t3hbeowulf/itxllama/docs/storage.md

# ITX Llama Storage Options

The ITX Llama provides several convenient options for installing your favorite version of DOS, Windows 3.1, and/or Windows 95/98. 

With an onboard SATA port, you can use a SATA SSD or even an HDD for a more authentic speed and sound. There is a microSD card slot which BIOS intializes as a mass storage device, usable by DOS and Windows without special drivers. Two of the USB ports on the rear can be configured in "Removable mode" or "Mass Storage" mode as well. 

## Configuration Examples

1. Easy mode:
    * Operating system is stored on the internal microSD card
    * Optical drive or optical drive emulator is connected to the SATA port
    * USB drive is attached in Mass Storage mode for bulk storage

1. Hard mode:
    * Operating system is stored on a SATA SSD
    * Internal microSD card is bulk storage and hosts ISOs to be mounted by the OS
    * USB drive is attached in Removable mode, usable only in Windows 95/98 with drivers
