t3hbeowulf/itxllama/kicad/ITX-Llama.kicad_sch

## KiCad design kicad/ITX-Llama.kicad_sch (2025-06-28)

Schematic: ITX-Llama.kicad_sch

Parts:
BT1: CR2032; BT_BS-02-A1AJ006; LCSC C964745
C1, C2, C3, C4: 100uF; C_1210_3225Metric; LCSC C90143
C5, C10, C11, C31, C32, C43, C44, C45, C46, C47, C53, C61, C62, C76, C77, C159, C161, C167, C168, C169, C170, C171, C173: 47uF; C_0603_1608Metric; LCSC C140782
C6, C7, C8, C12, C13, C14, C16, C17, C18, C22, C25, C26, C29, C37, C38, C39, C40, C41, C42, C51, C54, C56, C57, C58, C59, C60, C63, C72, C73, C84, C85, C86, C87, C89, C90, C91, C92, C93, C94, C95, C96, C97, C98, C99, C100, C101, C102, C103, C104, C105, C106, C107, C108, C109, C110, C111, C112, C113, C114, C115, C116, C117, C118, C119, C120, C122, C123, C124, C129, C130, C131, C138, C144, C145, C146, C153, C156, C162, C163, C164, C165, C166, C182, C183, C184, C185, C186, C187, C188, C189, C190: 0.1uF; C_0402_1005Metric
C9, C33, C34, C52, C69, C74, C75, C134, C137, C143, C147, C148, C149, C158, C176: 10uF; C_0603_1608Metric
C15, C24, C28, C65, C66, C67, C78, C121, C132, C135, C150, C151, C152, C177, C178: 1uF; C_0402_1005Metric
C19, C23, C35, C36, C125, C126: 1nF; C_0402_1005Metric
C20, C21: 22pF; C_0402_1005Metric
C27: 47uF; C_0603_1608Metric
C30, C68: 2.7nF; C_0603_1608Metric
C48, C49, C50: 330pF; C_0402_1005Metric
C55, C64, C160: 10nF; C_0402_1005Metric
C70, C71: 0.33uF; C_0402_1005Metric
C79, C133, C136, C157: 470pF; C_0402_1005Metric
C80: 1nF; C_1812_4532Metric; Voltage min. 2kV; LCSC C106132
C81, C82, C83: 0.1uF; C_0402_1005Metric; LCSC C14663
C88, C154, C155: 4.7uF; C_0603_1608Metric
C127, C128: 5.6nF; C_0402_1005Metric
C139, C140: 2.2uF; C_0603_1608Metric
C141, C142: 2.2nF; C_0402_1005Metric
C172, C174, C175: 10uF; C_0603_1608Metric; LCSC C140782
C179: 0.1uF; C_0402_1005Metric; LCSC C107004
C180, C181: 30pF; C_0402_1005Metric; LCSC C107004
D1: RGB_LED; D_LED_D5.0mm-4_RGB; LCSC C417349
D2, D3, D4: 1N4148; D_SOD-323F; LCSC C2128
F1, F2, F5, F6, F7: F; Fuse_0603_1608Metric
F3, F4: F; Fuse_0603_1608Metric; LCSC C207017
FB1, FB2: 600Ω@100MHz; R_0402_1005Metric; LCSC C160977
FB3: 50Ω@100MHz; R_1206_3216Metric; LCSC C88997
FB4, FB5, FB6, FB7, FB8, FB9: 70Ω@100MHz; R_0603_1608Metric; LCSC C113031
H1, H2, H3, H4: H_HOLE; H_ATX_PERF
J1: ATX_POWER; J_ATX_5.5mm; LCSC C114125
J2: MICRO_SD; J_MicroSD_TF01A; LCSC C91145
J3: FRONT_PANEL; P_CONN_PANEL; LCSC C492421
J4: PS/2; J_PS2_KMDGX
J5: AGP_3.3V; J_TE_5145263-3
J6: CLICK_VOL; P_CONN_SPKR_VOL
J7: MSC; P_CONN_01X03
J8: COM1; J_DE9M; LCSC C141880
J9: INT_SPKR_VOL; P_CONN_SPKR_VOL
J10: SATA; J_SATA; LCSC C2926809
J11: SPEAKER; P_CONN_01X04; LCSC C492403
J12: MSD; P_CONN_01X03
J14: AUDIO; J_AUDIO_ABA-JAK-027-K24; LCSC C962118
J15: KBC; P_CONN_01X03
J16: KBD; P_CONN_01X03
J17: USB_ETH; J_USB_A_ETH_C3000093; LCSC C3000093
J18: USB_HID; J_USB_A_C456021; LCSC C456021
J19: HID_POWER; P_CONN_01X02
J20: FAN1; J_MOLEX_47053-1000; LCSC C240840
J21: FAN2; J_MOLEX_47053-1000; LCSC C240840
J22: GAMEPORT; J_DA15; LCSC C77835
J23: WAVETABLE; J_CONN_WAVETABLE; LCSC C2884022
J24: PI_ZERO2; J_CONN_RPI_SMD; LCSC C3975165
J25: POWER; P_CONN_01X03
J26: LEFT; P_CONN_01X03
J27: RIGHT; P_CONN_01X03
J28: COM2_TTL; P_CONN_01X03
J29: PI_2/3/4; J_CONN_RPI_SMD_PI3; LCSC C2884029
J30: FAN3; J_MOLEX_47053-1000; LCSC C240840
J31: FAN1_VDD; P_CONN_01X03
J32: FAN2_VDD; P_CONN_01X03
J33: FAN3_VDD; P_CONN_01X03
J34: CD_IN; J_CONN_CD_AUDIO; LCSC C41927
J35: D1_MINI; J_WEMOS_D1_MINI
J36: ESP_POWER; P_CONN_01X02
J38: J_TOSLINK_ZGY133T10; LCSC C277782
J39: LINE_L; P_CONN_01X03
J40: LINE_R; P_CONN_01X03
J41: EXT_SYNTH; J_CONN_02X10
J42: PI_I2C; P_CONN_01X04
J43: I2C; P_CONN_01X04_NO_3D
J46: RP_DEBUG; P_CONN_01X03
L1, L2: L_EMI_FILTER; L_EMI_FILTER_MCM2012B900GBE; LCSC C315725
L3, L4: L_EMI_FILTER; L_EMI_FILTER_MCM2012B900GBE
LOGO1: Llama_logo; LLAMA_LOGO
OUTLINE1: Outline; OUTLINE_PANELIZED
P1: P_SOM-128-EX; P_CONN_SOM-128-EX_FAN; LCSC C2881937
Q1, Q2, Q3, Q4, Q5, Q6, Q7: NPN; Q_BJT_SOT-23-3; LCSC C2146
Q8, Q9, Q10, Q11: Q_NMOS_GDS; Q_NFET_ENH_SOT-23-3; LCSC C255592
R1, R2, R3, R4, R5, R6, R27, R60, R61: 47k; R_0402_1005Metric
R7, R8, R9, R11, R12, R40, R53, R118: 33; R_0402_1005Metric
R10: 0; R_0402_1005Metric
R13, R20, R42, R57, R81, R82, R87, R88, R97, R100, R102, R110, R111, R112, R115, R120: 10k; R_0402_1005Metric
R14, R98, R101: 470; R_0402_1005Metric
R15, R16, R28, R62, R66, R67, R84, R85, R86, R89, R90, R91: 4.7k; R_0402_1005Metric
R17, R63: 600; R_0402_1005Metric
R18, R74, R75, R116: 330; R_0402_1005Metric
R19, R64: 2k; R_0402_1005Metric
R21, R22, R24, R25, R103, R104, R105, R106: 6.8k; R_0402_1005Metric
R23, R26, R29, R30, R31, R32, R33, R34, R35, R36, R37, R38, R41, R46, R47, R48, R49, R50, R51, R52, R54, R79, R80, R108, R121: 5.1k; R_0402_1005Metric
R39, R117: 200; R_0402_1005Metric
R43, R44, R55, R58, R78, R119: 1k; R_0402_1005Metric
R45, R56: 27; R_0402_1005Metric
R59, R94, R95, R96: 470; R_0805_2012Metric; LCSC C17710
R65: 1.43k; R_0402_1005Metric
R68, R69, R76, R77: 75; R_0402_1005Metric
R70, R71, R72, R73: 49.9; R_0402_1005Metric
R83, R107: 3.4k; R_0402_1005Metric
R92, R93: 2.2k; R_0402_1005Metric
R99: 20k; R_0402_1005Metric
R109: 22; R_0402_1005Metric
R113: 15.8k; R_0402_1005Metric
R114: 36k; R_0402_1005Metric
SP1, SP2: SPEAKER; SP; LCSC C252917
SW1: POWER; SW_B3FS-1010; LCSC C271750
SW2: RESET; SW_B3FS-1010; LCSC C271750
SW3: CH559_PRG; SW_B3FS-1010; LCSC C271750
T1: Pulse_H1102NL; T_PULSE_H1102NL; LCSC C18584
U1: MAX16054; U_TSOT-23-6; LCSC C79401
U2: U_74LVC1G04; U_SOT-23-5; LCSC C7827
U3: U_CS4237B-KQ; U_TQFP-100_14x14mm_P0.5mm_HandSoldering
U4: GD75232; U_TSSOP-20_4.4x6.5mm_P0.65mm; LCSC C543039
U5: U_MC33078; SOIC-8_3.9x4.9mm_P1.27mm; LCSC C108206
U6: PI7C9X118SL; U_LQFP-128_14x14mm_P0.4mm_EP
U7: AP7165; U_Diodes_SO-8EP; LCSC C460364
U8, U10, U13, U14: U_MIC5219-3.3YM5; U_SOT-23-5; LCSC C29613
U9: U_ATTINY84A; U_DIP-14_W7.62mm
U11: EMC2303; U_EMC2303; LCSC C621414
U12: PCM5102A; U_TSSOP-20_4.4x6.5mm_P0.65mm; LCSC C107671
U15: W25Q32JVSS; U_SOIC-8_5.23x5.23mm_P1.27mm
U16: U_74LVC1G126; U_SOT-23-5; LCSC C7834
U17: U_RP2040; U_QFN40P700X700X90-57N
X1: 16.9344MHz; X_Crystal_SMD_HC49S-MINI; LCSC C4944017
X2: 12MHz; X_SMD3225; LCSC C9002

Connections:
3.3V_MIDI_OUT: J24.10 (BCM15/RDX), J29.10 (BCM15/RDX), R99.1, R100.2
+1.8V: FB3.1, P1.A56 (VCC1.8_OUT)
+1.15V: C75.2, C153.2, FB6.1, FB7.1, R113.1, U7.7 (VOUT), U7.8 (VOUT)
+1.15V_VDDA: C101.2, C102.2, C155.2, FB7.2, U6.15 (VDDA), U6.18 (VDDA)
+1.15V_VDDC: C89.2, C90.2, C91.2, C92.2, C93.2, C94.2, C95.2, C96.2, C97.2, C98.2, C99.2, C100.2, C154.2, FB6.2, U6.7 (VDDCAUX), U6.30 (VDDC), U6.35 (VDDC), U6.45 (VDDC), U6.53 (VDDC), U6.62 (VDDC), U6.73 (VDDC), U6.81 (VDDC), U6.95 (VDDC), U6.105 (VDDC), U6.114 (VDDC), U6.127 (VDDC)
+3.3V: C3.1, C7.1, C12.1, C22.2, C74.2, C122.1, FB4.1, FB5.1, FB8.1, FB9.1, J1.1 (+3.3V), J1.2 (+3.3V), J1.12 (+3.3V), J1.13 (+3.3V), J2.4 (VDD), R1.1, R2.1, R3.1, R4.1, R5.1, R6.1, R74.1, R75.1, R79.1, R80.1, R84.2, R85.2, R86.2, R87.1, R88.1, R95.1, R102.1, R120.2, U2.5 (VCC), U3.45 (VD1), U7.1 (VIN), U7.2 (VIN), U7.4 (EN), U11.3 (VDD)
+3.3VSB: C156.2, C158.1, U9.1 (VCC), U10.5 (OUT)
+3.3V_118SL: C103.2, C104.2, C105.2, C106.2, C107.2, C108.2, C109.2, C110.2, C111.2, C112.2, C113.2, C114.2, C115.2, C116.2, C117.2, C118.2, C119.2, FB4.2, R33.2, R34.2, R36.1, R37.1, R38.1, R51.1, R52.1, R54.1, R108.2, R121.2, U6.2 (VAUX), U6.25 (VD33), U6.38 (VD33), U6.50 (VD33), U6.55 (VD33), U6.58 (VD33), U6.66 (VD33), U6.72 (VD33), U6.77 (VD33), U6.82 (VD33), U6.87 (VD33), U6.91 (VD33), U6.101 (VD33), U6.107 (VD33), U6.112 (VD33), U6.118 (VD33), U6.123 (VD33)
+3.3V_PCM_A: C137.1, C143.1, C144.1, U12.8 (AVDD), U14.5 (OUT)
+3.3V_PCM_D: C134.1, C138.1, C145.1, C147.1, C148.1, U12.1 (CPVDD), U12.17 (XSMT), U12.20 (DVDD), U13.5 (OUT)
+3.3V_VDDA: C88.2, C120.2, FB5.2, U6.10 (VDDA33)
+5VA: C25.1, C72.1, FB1.2, U3.81 (VA), U5.8 (VCC)
+5VFILT: C13.2, C14.2, C16.2, C18.2, FB2.2, U3.17 (VDF1), U3.54 (VDF4), U3.65 (VDF2), U3.98 (VDF3)
+5VSB: C8.2, C121.1, D1.2 (A), J1.9 (+5VSB), R59.1, U1.6 (VCC), U10.1 (IN), U10.3 (EN)
+12V: C1.1, C51.2, C52.2, C172.1, C174.1, C175.1, J1.10 (+12V), J1.11 (+12V), J5.A1 (+12V), J23.18 (+12V), J31.1, J32.1, J33.1, R96.1, U4.1 (VDD)
-12V: C4.2, J1.14 (-12V), J23.22 (-12V), U4.10 (VSS)
A0: P1.B3 (GP70), U3.25 (SA0)
A1: P1.B4 (GP71), U3.26 (SA1)
A2: P1.B5 (GP72), U3.27 (SA2)
A3: P1.B6 (GP73), U3.28 (SA3)
A4: P1.B7 (GP74), U3.29 (SA4)
A5: P1.B8 (GP75), U3.30 (SA5)
A6: P1.B9 (GP76), U3.31 (SA6)
A7: P1.B10 (GP77), U3.32 (SA7)
A8: P1.B11 (GP60), U3.33 (SA8)
A9: P1.B12 (GP61), U3.34 (SA9)
A10: P1.B13 (GP62), U3.35 (SA10)
A11: P1.B14 (GP63), U3.36 (SA11)
A12: P1.B15 (GP64), U3.94 (SA12)
A13: P1.B16 (GP65), U3.93 (SA13)
A14: P1.B17 (GP66), U3.92 (SA14)
A15: P1.B18 (GP67), U3.91 (SA15)
AD_STB0: J5.B59 (AD_STB0), R26.2
AD_STB1: J5.B32 (AD_STB1), R29.2
AEN: P1.B33 (GP44), U3.39 (AEN)
AUDIO_L_PI: C141.2, J26.3, R98.2
AUDIO_L_WT: J23.24 (AUDIO_L), J26.1
AUDIO_R_PI: C142.2, J27.3, R101.2
AUDIO_R_WT: J23.20 (AUDIO_R), J27.1
AUDIO_VREF: R60.2, U3.78 (VREF)
BOOTSEL: R43.2, SW3.1 (A)
CTS1: P1.A10 (GP07), U4.14 (RY4)
D0: P1.B47 (GP20), U3.41 (SD0)
D1: P1.B48 (GP21), U3.42 (SD1)
D2: P1.B49 (GP22), U3.43 (SD2)
D3: P1.B50 (GP23), U3.44 (SD3)
D4: P1.B51 (GP24), U3.47 (SD4)
D5: P1.B52 (GP25), U3.48 (SD5)
D6: P1.B53 (GP26), U3.49 (SD6)
D7: P1.B54 (GP27), U3.50 (SD7)
DCD1: P1.A3 (GP00), U4.19 (RY1)
DRQ1: P1.B27 (GP56), U3.51 (DRQB(DRQ1*))
DSR1: P1.A9 (GP06), U4.18 (RY2)
DTR1: P1.A8 (GP05), U4.13 (DA3)
FM_A0: J41.18, U3.14 (SCL/XA0)
FM_A1: J41.16, U3.13 (XA1)
FM_D0: J41.12, U3.8 (SDA/XD0)
FM_D1: J41.11, U3.7 (XD1/SCLK)
FM_D2: J41.10, U3.6 (XD2/SDIN)
FM_D3: J41.9, U3.5 (XD3/SDOUT)
FM_D4: J41.8, U3.4 (XD4/FSYNC)
FM_D5: J41.7, U3.3 (XD5/MCLK)
FM_D6: J41.6, U3.2 (XD6/LRCK)
FM_D7: J41.5, U3.1 (XD7/SDATA)
FM_SYNTH_L: C24.2, J41.1
FM_SYNTH_R: C28.2, J41.2
GND: BT1.2 (-), C1.2, C2.2, C3.2, C4.1, C5.2, C6.2, C7.2, C8.1, C9.2, C10.1, C11.1, C12.2, C13.1, C14.1, C15.2, C16.1, C17.2, C18.1, C19.2, C20.1, C21.1, C22.1, C23.2, C25.2, C26.1, C27.1, C30.2, C31.2, C32.2, C35.2, C36.2, C37.1, C38.1, C39.1, C40.1, C41.1, C42.1, C43.2, C44.2, C45.2, C46.2, C47.2, C48.1, C49.1, C50.1, C51.1, C52.1, C53.2, C54.1, C55.2, C56.1, C57.1, C58.1, C59.1, C60.1, C61.2, C62.2, C63.1, C64.2, C67.1, C69.2, C72.2, C74.1, C75.1, C76.2, C77.2, C78.2, C79.2, C80.1, C81.1, C82.1, C83.1, C88.1, C89.1, C90.1, C91.1, C92.1, C93.1, C94.1, C95.1, C96.1, C97.1, C98.1, C99.1, C100.1, C101.1, C102.1, C103.1, C104.1, C105.1, C106.1, C107.1, C108.1, C109.1, C110.1, C111.1, C112.1, C113.1, C114.1, C115.1, C116.1, C117.1, C118.1, C119.1, C120.1, C121.2, C122.2, C123.1, C124.1, C125.1, C126.1, C127.1, C128.1, C129.1, C130.1, C131.1, C132.2, C133.2, C134.2, C135.2, C136.2, C137.2, C138.2, C139.1, C141.1, C142.1, C143.2, C144.2, C145.2, C146.1, C147.2, C148.2, C149.1, C153.1, C154.1, C155.1, C156.1, C157.2, C158.2, C159.2, C160.2, C161.2, C162.1, C163.2, C164.1, C165.1, C166.1, C167.2, C168.2, C169.2, C170.2, C171.2, C172.2, C173.2, C174.2, C175.2, C176.2, C177.2, C178.2, C179.1, C180.2, C181.2, C182.1, C183.1, C184.1, C185.1, C186.1, C187.1, C188.1, C189.1, C190.1, H1.1, H2.1, H3.1, H4.1, J1.3 (GND), J1.5 (GND), J1.7 (GND), J1.15 (GND), J1.17 (GND), J1.18 (GND), J1.19 (GND), J1.24 (GND), J2.6 (VSS), J2.S (Shield), J3.4, J3.5, J4.A3 (GND), J4.B3 (GND), J4.S (SHIELD), J5.A3 (RES_GND), J5.A5 (GND), J5.A13 (GND), J5.A19 (GND), J5.A31 (GND), J5.A37 (GND), J5.A43 (GND), J5.A49 (GND), J5.A55 (GND), J5.A61 (GND), J5.B5 (GND), J5.B13 (GND), J5.B19 (GND), J5.B31 (GND), J5.B37 (GND), J5.B43 (GND), J5.B49 (GND), J5.B55 (GND), J5.B61 (GND), J8.5, J10.1 (GND), J10.4 (GND), J10.7 (GND), J11.3, J14.1, J17.U4 (GND1), J17.U8 (GND2), J18.4 (GND1), J18.8 (GND2), J18.S (Shield), J20.1 (GND), J21.1 (GND), J22.4, J22.5, J22.S (SHIELD), J23.1 (GND), J23.3 (GND), J23.5 (GND), J23.7 (GND), J23.9 (GND), J23.11 (GND), J23.15 (AGND), J23.17 (AGND), J23.19 (AGND), J23.21 (AGND), J23.23 (AGND), J23.25 (AGND), J24.6 (GND), J24.9 (GND), J24.14 (GND), J24.20 (GND), J24.25 (GND), J24.30 (GND), J24.34 (GND), J24.39 (GND), J28.2, J29.6 (GND), J29.9 (GND), J29.14 (GND), J29.20 (GND), J29.25 (GND), J29.30 (GND), J29.34 (GND), J29.39 (GND), J30.1 (GND), J35.10 (GND), J38.3 (GND), J41.3, J41.20, J42.1 (GND), J43.1 (GND), J46.2, P1.A2 (GND), P1.A19 (GND), P1.A20 (GND), P1.A25 (AGND), P1.A26 (AGND), P1.A35 (GND), P1.A36 (GND), P1.A49 (GND), P1.A50 (GND), P1.A64 (GP87), P1.B19 (GND), P1.B20 (GND), P1.B37 (GND), P1.B38 (GND), P1.B55 (GND), P1.B56 (GND), Q1.2 (E), Q2.2 (E), Q3.2 (E), Q4.2 (E), Q5.2 (E), Q6.2 (E), Q7.2 (E), R22.2, R25.2, R28.2, R59.2, R78.2, R94.2, R95.2, R96.2, R99.2, R105.2, R106.2, R107.2, R114.2, SW1.1 (A), SW2.1 (A), SW3.2 (B), U1.2 (GND), U1.3 (CLEAR), U3.18 (SGND1), U3.46 (DGND1), U3.53 (SGND4), U3.66 (SGND2), U3.71 (TEST), U3.80 (AGND), U3.97 (SGND3), U4.11 (GND), U5.4 (GND), U6.6 (VSS), U6.11 (VSS), U6.14 (VSS), U6.19 (VSS), U6.22 (VSS), U6.23 (TM1), U6.42 (VSS), U6.44 (CLKIN), U6.65 (VSS), U6.84 (VSS), U6.115 (VSS), U6.128 (TM0), U6.129 (EPAD), U7.5 (GND), U7.9 (GND), U8.2 (GND), U9.14 (GND), U10.2 (GND), U11.9 (CLK), U11.13 (GND), U12.3 (CPGND), U12.9 (AGND), U12.10 (DEMP), U12.11 (FLT), U12.12 (SCK), U12.16 (FMT), U12.19 (DGND), U13.2 (GND), U14.2 (GND), U15.4 (GND), U16.3 (GND), U17.19 (TESTEN), U17.57 (GND), X2.2, X2.4
HDD_LED+: J3.1, R116.2
HDD_LED-: J3.2, Q6.3 (C)
HID_VCC: C78.1, F5.1, F6.1, J19.2, U8.1 (IN), U8.3 (EN)
I2S_BCLK: J24.12 (BCM18/PWM0), J29.12 (BCM18/PWM0), U12.13 (BCK)
I2S_DATA: J24.40 (BCM21/SCLK), J29.40 (BCM21/SCLK), U12.14 (DIN)
I2S_LRCLK: J24.35 (BCM19/MISO), J29.35 (BCM19/MISO), U12.15 (LRCK)
INT_MIDI_L: J26.2, J39.1
INT_MIDI_R: J27.2, J40.1
IOCHRDY: P1.B34 (GP45), U3.40 (IOCHRDY)
IRQ7: P1.B21 (GP50), U3.23 ((INT7*)IRQB)
JAB1: C126.2, J22.2, R91.2, U3.70 (JAB1)
JAB2: C125.2, J22.7, R90.2, U3.61 (JAB2)
JACX: C128.2, R92.2, U3.68 (JACX)
JACX_: J22.3, R92.1
JACY: C127.2, R93.2, U3.63 (JACY)
JACY_: J22.6, R93.1
KBCLK: J15.2, P1.A12 (GP91), R66.1
KBDATA: J16.2, P1.A14 (GP93), R67.1
LAN_RD+: P1.A54 (LAN_RX+), R72.2, T1.6 (RD+)
LAN_RD-: P1.A52 (LAN_RX-), R73.2, T1.8 (RD-)
LAN_TD+: P1.A53 (LAN_TX+), R70.2, T1.1 (TD+)
LAN_TD-: P1.A51 (LAN_TX-), R71.2, T1.3 (TD-)
LIN: J14.10, J39.3
LINE_IN_L: J39.2, R21.1
LINE_IN_R: J40.2, R24.1
LMIC: C73.1, J14.3
LOUT: C34.2, J14.7
M66EN: R121.1, U6.102 (M66EN)
MIDI_IN: J22.15, R89.2, U3.59 (MIDIN)
MIDI_OUT: J22.12, J23.4 (MIDI_IN), R100.1, U3.60 (MIDOUT)
MSCLK: J7.2, P1.A13 (GP92), R15.1
MSDATA: J12.2, P1.A15 (GP94), R16.1
unnamed: C10.2, F1.2, J4.A4 (VCC)
unnamed: C11.2, F2.2, J4.B4 (VCC)
unnamed: C15.1, C17.1, U3.79 (REFFLT)
unnamed: C19.1, U3.76 (RFILT)
unnamed: C20.2, U3.99 (XTALO), X1.1
unnamed: C21.2, U3.100 (XTALI), X1.2
unnamed: C23.1, U3.77 (LFILT)
unnamed: C24.1, U3.87 (LLINE)
unnamed: C28.1, U3.86 (RLINE)
unnamed: C29.1, U3.88 (MIN)
unnamed: C29.2, C30.1, R27.2, R28.1
unnamed: C31.1, F3.2, J17.U1 (VBUS1)
unnamed: C32.1, F4.2, J17.U5 (VBUS2)
unnamed: C33.1, C36.1, U3.72 (ROUT)
unnamed: C34.1, C35.1, U3.73 (LOUT)
unnamed: C55.1, Q1.3 (C), R39.1, R40.1
unnamed: C64.1, Q2.3 (C), R53.2
unnamed: C65.1, U3.74 (RAUX1)
unnamed: C65.2, R24.2, R25.1
unnamed: C66.1, U3.75 (LAUX1)
unnamed: C66.2, R21.2, R22.1
unnamed: C67.2, R60.1, U5.3 (+)
unnamed: C68.1, C70.1, C71.1, R62.1, U5.7
unnamed: C68.2, R62.2, R63.1, U5.6 (-)
unnamed: C69.1, R63.2
unnamed: C70.2, U3.83 (LMIC)
unnamed: C71.2, U3.82 (RMIC)
unnamed: C73.2, R61.2, U5.5 (+)
unnamed: C76.1, F5.2, J18.1 (VBUS1)
unnamed: C77.1, F6.2, J18.5 (VBUS2)
unnamed: C79.1, U8.4 (BYP)
unnamed: C80.2, R68.1, R69.1, R76.1, R77.1
unnamed: C81.2, FB3.2, T1.2 (C_TD), T1.7 (C_RD)
unnamed: C82.2, R70.1, R71.1
unnamed: C83.2, R72.1, R73.1
unnamed: C123.2, F7.1, J22.1, J22.8, J22.9
unnamed: C133.1, U13.4 (BYP)
unnamed: C136.1, U14.4 (BYP)
unnamed: C139.2, U12.5 (VNEG)
unnamed: C140.1, U12.2 (CAPP)
unnamed: C140.2, U12.4 (CAPM)
unnamed: C146.2, C149.2, U12.18 (LDOO)
unnamed: C150.1, U3.85 (LAUX2)
unnamed: C150.2, R104.1, R105.1
unnamed: C151.1, U3.84 (RAUX2)
unnamed: C151.2, R103.1, R106.1
unnamed: C152.1, U3.96 (CMAUX2)
unnamed: C152.2, R83.1, R107.1
unnamed: C157.1, U10.4 (BYP)
unnamed: C160.1, Q3.3 (C), R117.1, R118.1
unnamed: C161.1, J35.9 (5V), J36.2
unnamed: C180.1, R58.2, X2.3
unnamed: C181.1, U17.20 (XIN), X2.1
unnamed: D1.1 (RK), R17.2
unnamed: D1.3 (GK), R19.2
unnamed: D2.2 (A), J9.2, SP1.2
unnamed: D3.2 (A), J11.1, R53.1
unnamed: D4.2 (A), J6.2, SP2.2
unnamed: J6.1, R117.2
unnamed: J6.3, R118.2
unnamed: J9.1, R39.2
unnamed: J9.3, R40.2
unnamed: J17.D1, R74.2
unnamed: J17.D3, R75.2
unnamed: J17.J1, T1.16 (TX+)
unnamed: J17.J2, T1.14 (TX-)
unnamed: J17.J3, T1.11 (RX+)
unnamed: J17.J4, J17.J5, R76.2
unnamed: J17.J6, T1.9 (RX-)
unnamed: J17.J7, J17.J8, R77.2
unnamed: J20.2 (VDD), J31.2
unnamed: J21.2 (VDD), J32.2
unnamed: J30.2 (VDD), J33.2
unnamed: J34.1, R103.2
unnamed: J34.2, J34.3, R83.2
unnamed: J34.4, R104.2
unnamed: J38.1 (VIN), U16.4
unnamed: Q1.1 (B), R44.2
unnamed: Q2.1 (B), R55.2
unnamed: Q3.1 (B), R119.2
unnamed: Q4.1 (B), R81.2
unnamed: Q4.3 (C), R17.1
unnamed: Q5.1 (B), R82.2
unnamed: Q5.3 (C), R19.1
unnamed: Q6.1 (B), R115.2
unnamed: Q7.1 (B), R20.2
unnamed: R36.2, U6.32 (~REQ1)
unnamed: R37.2, U6.34 (~REQ2)
unnamed: R38.2, U6.33 (~REQ3)
unnamed: R45.2, U17.47 (USB_DP)
unnamed: R56.2, U17.46 (USB_DM)
unnamed: R57.2, U17.26 (RUN)
unnamed: R58.1, U17.21 (XOUT)
unnamed: R61.1, R64.1, U5.1, U5.2 (-)
unnamed: R65.1, U6.8 (REXTP)
unnamed: R65.2, U6.9 (REXTN)
unnamed: R68.2, T1.10 (C_RX)
unnamed: R69.2, T1.15 (C_TX)
unnamed: R78.1, U6.24 (TMS)
unnamed: R86.1, U11.4 (ADDR_SEL)
unnamed: R98.1, U12.6 (OUTL)
unnamed: R101.1, U12.7 (OUTR)
unnamed: R108.1, U6.1 (~PME)
unnamed: R109.2, U6.59 (CLKOUT0)
unnamed: R113.2, R114.1, U7.6 (FB)
unnamed: R120.1, U9.4 (PB3/PCINT11/~RESET)
PAR: J5.A50 (PAR), U6.94 (PAR)
PCI_AD0: J5.A65 (AD[0]), U6.64 (AD0)
PCI_AD1: J5.B65 (AD[1]), U6.67 (AD1)
PCI_AD2: J5.A63 (AD[2]), U6.69 (AD2)
PCI_AD3: J5.B63 (AD[3]), U6.68 (AD3)
PCI_AD4: J5.A62 (AD[4]), U6.70 (AD4)
PCI_AD5: J5.B62 (AD[5]), U6.71 (AD5)
PCI_AD6: J5.A60 (AD[6]), U6.74 (AD6)
PCI_AD7: J5.B60 (AD[7]), U6.75 (AD7)
PCI_AD8: J5.B57 (AD[8]), U6.78 (AD8)
PCI_AD9: J5.A56 (AD[9]), U6.79 (AD9)
PCI_AD10: J5.B56 (AD[10]), U6.80 (AD10)
PCI_AD11: J5.A54 (AD[11]), U6.83 (AD11)
PCI_AD12: J5.B54 (AD[12]), U6.85 (AD12)
PCI_AD13: J5.A53 (AD[13]), U6.86 (AD13)
PCI_AD14: J5.B53 (AD[14]), U6.88 (AD14)
PCI_AD15: J5.A51 (AD[15]), U6.90 (AD15)
PCI_AD16: J5.A39 (AD[16]), U6.104 (AD16)
PCI_AD17: J5.B38 (AD[17]), U6.103 (AD17)
PCI_AD18: J5.A38 (AD[18]), U6.106 (AD18)
PCI_AD19: J5.B36 (AD[19]), U6.108 (AD19)
PCI_AD20: J5.A36 (AD[20]), U6.109 (AD20)
PCI_AD21: J5.B35 (AD[21]), U6.110 (AD21)
PCI_AD22: J5.A35 (AD[22]), U6.111 (AD22)
PCI_AD23: J5.B33 (AD[23]), U6.113 (AD23)
PCI_AD24: J5.A30 (AD[24]), U6.117 (AD24)
PCI_AD25: J5.B30 (AD[25]), U6.119 (AD25)
PCI_AD26: J5.A29 (AD[26]), U6.120 (AD26)
PCI_AD27: J5.B29 (AD[27]), U6.122 (AD27)
PCI_AD28: J5.A27 (AD[28]), U6.121 (AD28)
PCI_AD29: J5.B27 (AD[29]), U6.124 (AD29)
PCI_AD30: J5.A26 (AD[30]), U6.126 (AD30)
PCI_AD31: J5.B26 (AD[31]), U6.125 (AD31)
PCI_CLK0: J5.B7 (CLK), R109.1
PE0_CLK+: C85.2, P1.A45 (PE0_CLK-)
PE0_CLK+_: C85.1, U6.13 (REFCLKP)
PE0_CLK-: C84.2, P1.A47 (PE0_CLK+)
PE0_CLK-_: C84.1, U6.12 (REFCLKN)
PE0_RX+: C87.2, P1.A44 (PE0_RX+)
PE0_RX+_: C87.1, U6.17 (TP)
PE0_RX-: C86.2, P1.A42 (PE0_RX-)
PE0_RX-_: C86.1, U6.16 (TN)
PE0_TX+: P1.A41 (PE0_TX-), U6.21 (RP)
PE0_TX-: P1.A43 (PE0_TX+), U6.20 (RN)
PI7_SCL: R80.2, U6.3 (SCL)
PI7_SDA: R79.2, U6.5 (SDA)
PI_SCL: J24.5 (BCM3/SCL), J29.5 (BCM3/SCL), J42.3 (SCL)
PI_SDA: J24.3 (BCM2/SDA), J29.3 (BCM2/SDA), J42.4 (SDA)
PS2_KBCLK: J4.A5 (KBCLK), J15.3
PS2_KBDATA: J4.A1 (KBDATA), J16.3
PS2_MSCLK: J4.B5 (MSCLK), J7.3
PS2_MSDATA: J4.B1 (MSDATA), J12.3
PWM1: J20.4 (PWM), U11.5 (PWM1)
PWM2: J21.4 (PWM), U11.7 (PWM2)
PWM3: J30.4 (PWM), U11.11 (PWM3)
PWM_CLICK: R119.1, U9.8 (PCINT5/OC1B/PA5)
PWM_GREEN: R82.1, U9.10 (PCINT3/PA3)
PWM_HDD: R115.1, U9.12 (PCINT1/PA1)
PWM_PWR: R20.1, U9.13 (PCINT0/PA0)
PWM_RED: R81.1, U9.11 (PCINT2/PA2)
PWR_LED+: J3.8, R18.2
PWR_LED-: J3.7, Q7.3 (C)
QSPI_CS: R42.1, R43.1, U15.1 (~CS), U17.56 (QSPI_CSN)
QSPI_SCK: U15.6 (CLK), U17.52 (QSPI_SCLK)
QSPI_SD0: U15.5 (DI(IO0)), U17.53 (QSPI_SD0)
QSPI_SD1: U15.2 (DO(IO1)), U17.55 (QSPI_SD1)
QSPI_SD2: U15.3 (IO2), U17.54 (QSPI_SD2)
QSPI_SD3: U15.7 (IO3), U17.51 (QSPI_SD3)
RI1: P1.A6 (GP03), U4.12 (RY5)
RIN: J14.13, J40.3
RMIC: J14.5, R64.2
ROUT: C33.2, J14.9
RP_1.1V: C177.1, C189.2, C190.2, U17.23 (DVDD), U17.45 (VREG_VOUT), U17.50 (DVDD)
RP_3.3V: C176.1, C178.1, C179.2, C182.2, C183.2, C184.2, C185.2, C186.2, C187.2, C188.2, Q8.1 (G), Q9.1 (G), Q10.1 (G), Q11.1 (G), R42.2, R57.1, R97.1, R110.1, R111.1, R112.1, U8.5 (OUT), U15.8 (VCC), U17.1 (IOVDD), U17.10 (IOVDD), U17.22 (IOVDD), U17.33 (IOVDD), U17.42 (IOVDD), U17.43 (ADC_AVDD), U17.44 (VREG_VIN), U17.48 (USB_VDD), U17.49 (IOVDD)
RP_RX: J46.3, U17.16 (GPIO13)
RP_TX: J46.1, U17.15 (GPIO12)
RSTDRV: U2.4, U3.90 (RESDRV)
RS_CTS1: J8.8, U4.7 (RA4)
RS_DCD1: J8.1, U4.2 (RA1)
RS_DSR1: J8.6, U4.3 (RA2)
RS_DTR1: C50.2, J8.4, U4.8 (DY3)
RS_RI1: J8.9, U4.9 (RA5)
RS_RTS1: C48.2, J8.7, U4.5 (DY1)
RS_RX1: J8.2, U4.4 (RA3)
RS_TX1: C49.2, J8.3, U4.6 (DY2)
RTS1: P1.A5 (GP02), U4.16 (DA1)
RX1: P1.A7 (GP04), U4.17 (RY3)
RX2: J28.3, J35.16 (TX/GPIO1), P1.B63 (GP16), U9.2 (PB0/PCINT8)
SATA_RX+: J10.6 (B+), P1.A40 (SATA_RX+)
SATA_RX-: J10.5 (B-), P1.A38 (SATA_RX-)
SATA_TX+: J10.2 (A+), P1.A39 (SATA_TX+)
SATA_TX-: J10.3 (A-), P1.A37 (SATA_TX-)
SB_STB: J5.B18 (SB_STB), R30.2
SD_CD: J2.9 (CD), P1.A63 (GP86), R1.2
SD_CLK: P1.A60 (GP83), R10.2
SD_CMD: P1.A59 (GP82), R9.2, U9.5 (PB2/PCINT10/INT0/OC0A)
SD_DAT0: P1.A61 (GP84), R11.2, U9.6 (PA7/PCINT7/OC0B)
SD_DAT1: P1.A62 (GP85), R12.2
SD_DAT2: P1.A57 (GP80), R7.2
SD_DAT3: P1.A58 (GP81), R8.2
SPDIF_OUT: U3.67 (JBCX*/SDOUT), U16.2
SPKR: P1.B58 (GP11), R27.1, R44.1, R55.1
TACH1: J20.3 (TACH), R88.2, U11.6 (TACH1)
TACH2: J21.3 (TACH), R87.2, U11.8 (TACH2)
TACH3: J30.3 (TACH), R102.2, U11.12 (TACH3)
TX1: P1.A4 (GP01), U4.15 (DA2)
TX2: J28.1, J35.15 (RX/GPIO3), P1.B61 (GP14), U9.3 (PB1/PCINT9)
USBD1+: L1.3, P1.A23 (USBD1+)
USBD1-: L1.2, P1.A21 (USBD1-)
USBD2+: L2.3, P1.A24 (USBD2+)
USBD2-: L2.2, P1.A22 (USBD2-)
USBDX1+: J17.U3 (D1+), L1.4
USBDX1-: J17.U2 (D1-), L1.1
USBDX2+: J17.U7 (D2+), L2.4
USBDX2-: J17.U6 (D2-), L2.1
USBHID1+: L3.3, R45.1
USBHID1-: L3.2, R56.1
USBHID2+: L4.3, U17.36 (GPIO24)
USBHID2-: L4.2, U17.37 (GPIO25)
USBHIDX1+: J18.7 (D2+), L3.4
USBHIDX1-: J18.6 (D2-), L3.1
USBHIDX2+: J18.3 (D1+), L4.4
USBHIDX2-: J18.2 (D1-), L4.1
USB_KBCLK_HV: J15.1, Q9.2 (D)
USB_KBCLK_LV: Q9.3 (S), R110.2, U17.5 (GPIO3)
USB_KBDATA_HV: J16.1, Q8.2 (D)
USB_KBDATA_LV: Q8.3 (S), R97.2, U17.4 (GPIO2)
USB_MSCLK_HV: J7.1, Q10.2 (D)
USB_MSCLK_LV: Q10.3 (S), R111.2, U17.7 (GPIO5)
USB_MSDATA_HV: J12.1, Q11.2 (D)
USB_MSDATA_LV: Q11.3 (S), R112.2, U17.6 (GPIO4)
V86_SCL: J43.3 (SCL), P1.B62 (GP15), R85.1, U9.9 (PCINT4/SCL/PA4), U11.2 (SMCLK)
V86_SDA: J43.4 (SDA), P1.B60 (GP13), R84.1, U9.7 (PA6/PCINT6/OCA1A/SDA), U11.1 (SMDATA)
VBATT: BT1.1 (+), P1.A55 (VBATT)
VCC: C2.1, C5.1, C6.1, C26.2, C27.2, C37.2, C124.2, C163.1, C171.1, D2.1 (K), D3.1 (K), D4.1 (K), F1.1, F2.1, F3.1, F4.1, F7.2, FB1.1, FB2.1, J1.4 (+5V), J1.6 (+5V), J1.21 (+5V), J1.22 (+5V), J1.23 (+5V), J5.B2 (+5V), J5.B3 (+5V), J11.4, J19.1, J25.2, J31.3, J32.3, J33.3, J36.1, J38.2 (VCC), J41.17, J43.2 (VCC), P1.B1 (VCC), P1.B2 (VCC), R13.1, R15.2, R16.2, R18.1, R66.2, R67.2, R89.1, R90.1, R91.1, R94.1, R116.1, SP1.1, SP2.1, U4.20 (VCC), U16.1 (OE), U16.5 (VCC)
VCC_3V3_AGP: C61.1, C62.1, C63.2, C129.2, C130.2, C131.2, C159.1, C162.2, C164.2, C165.2, C166.2, C167.1, C168.1, C173.1, FB8.2, J5.A9 (VCC_3.3V), J5.A16 (VCC_3.3V), J5.A28 (VCC_3.3V), J5.A45 (VCC_3.3V), J5.B9 (VCC_3.3V), J5.B16 (VCC_3.3V), J5.B28 (VCC_3.3V), J5.B45 (VCC_3.3V)
VCC_PI: C132.1, C135.1, J24.2 (5v), J24.4 (5v), J25.3, J29.2 (5v), J29.4 (5v), J42.2 (VCC), U13.1 (IN), U13.3 (EN), U14.1 (IN), U14.3 (EN)
VCC_VIO_AGP: C38.2, C39.2, C40.2, C41.2, C42.2, C43.1, C44.1, C45.1, C46.1, C47.1, C53.1, C54.2, C56.2, C57.2, C58.2, C59.2, C60.2, C169.1, C170.1, FB9.2, J5.A34 (Vddq3.3), J5.A40 (Vddq3.3), J5.A52 (Vddq3.3), J5.A58 (Vddq3.3), J5.A64 (Vddq3.3), J5.B34 (Vddq3.3), J5.B40 (Vddq3.3), J5.B47 (Vddq3.3), J5.B52 (Vddq3.3), J5.B58 (Vddq3.3), J5.B64 (Vddq3.3), R23.1, R26.1, R29.1, R30.1, R31.1, R32.1, R35.1, R41.1, R46.1, R47.1, R48.1, R49.1, R50.1
VCC_WT: J23.6 (VCC), J23.10 (VCC), J23.14 (VCC), J25.1
X_SD_CLK: J2.5 (CLK), R10.1
X_SD_CMD: J2.3 (CMD), R4.2, R9.1
X_SD_DAT0: J2.7 (DAT0), R3.2, R11.1
X_SD_DAT1: J2.8 (DAT1), R2.2, R12.1
X_SD_DAT2: J2.1 (DAT2), R6.2, R7.1
X_SD_DAT3: J2.2 (DAT3/CD), R5.2, R8.1
~BRESET: J23.26 (~RESET), J41.4, U3.15 (~BRESET)
~CBE0: J5.A57 (~C/BE[0]), U6.76 (~CBE0)
~CBE1: J5.B51 (~C/BE[1]), U6.89 (~CBE1)
~CBE2: J5.B39 (~C/BE[2]), U6.99 (~CBE2)
~CBE3: J5.A33 (~C/BE[3]), U6.116 (~CBE3)
~DACK1: P1.B28 (GP57), U3.56 (~DACKB(~DACK1*))
~DEVSEL: J5.B46 (~DEVSEL), R49.2, U6.98 (~DEVSEL)
~FM_CS: J41.13, U3.9 (~SCS/~UP)
~FM_RD: J41.14, U3.10 (~XIOR)
~FM_WR: J41.15, U3.11 (~XIOW)
~FRAME: J5.A41 (~FRAME), R46.2, U6.63 (~FRAME)
~GNT0: J5.A8 (~GNT), R41.2, U6.37 (~GNT0)
~INTA: J5.A6 (~INTA), R31.2, U6.36 (~INTA)
~INTB: J5.B6 (~INTB), R32.2, U6.43 (~INTB)
~INTC: R33.1, U6.57 (~INTC)
~INTD: R34.1, U6.60 (~INTD)
~IOR: P1.B40 (GP31), U3.37 (~IOR)
~IOW: P1.B39 (GP30), U3.38 (~IOW)
~IRDY: J5.B41 (~IRDY), R48.2, U6.97 (~IRDY)
~LAN_DUPLEX: J17.D2, P1.B57 (GP10)
~LAN_LINK_ACK: J17.D4, P1.B59 (GP12)
~LOCK: R51.2, U6.93 (~LOCK)
~PCIE_RST: P1.A46 (~PCIRST), U2.2, U6.29 (~PERST)
~PCI_RST: J5.A7 (~RST), U6.46 (~RESET)
~PERR: R52.2, U6.92 (~PERR)
~PIPE: J5.A12 (~PIPE), R23.2
~PS_ON: J1.16 (~PS_ON), U1.4 (~OUT)
~PWR_SW: J3.6, SW1.2 (B), U1.1 (IN)
~REQ0: J5.B8 (~REQ), R35.2, U6.31 (~REQ0)
~RST_SIG: C9.1, P1.A48 (~RESET), R14.1
~RST_SW: J3.3, R13.2, R14.2, SW2.2 (B)
~SERR: R54.2, U6.61 (~SERR)
~STOP: J5.A47 (~STOP), R50.2, U6.96 (~STOP)
~TRDY: J5.A46 (~TRDY), R47.2, U6.100 (~TRDY)

Notes on the sheet:
LED CONTROL
SATA
POWER, RESET, FRONT PANEL
NOTE: ~{RST_SIG} is a CPU input ~{PCIE_RST} is a CPU output
FAN CONTROL
WAVETABLE, PI
MICRO-SD, WIFI
SPEAKERS
Next to ADC_AVDD
AUDIO, GAMEPORT
USB, ETHERNET
One cap next to each IOVDD pin
Bleeder resistors
AGP SLOT
Make sure that the external synth module outputs max 1Vrms
SD_WP
Next to each DVDD pin
DECORATION
BATTERY
SERIAL
PCI BRIDGE
SYSTEM-ON-MODULE
MECHANICAL
PS/2
